tmcintos/MC88110_SmokeTest/README.md

# MC88110_SmokeTest
 MC88110 CPU Test Board
