tmcintos/MC88110_SmokeTest/MC88110_SmokeTest.brd

## EAGLE design MC88110_SmokeTest.brd (2025-04-10)

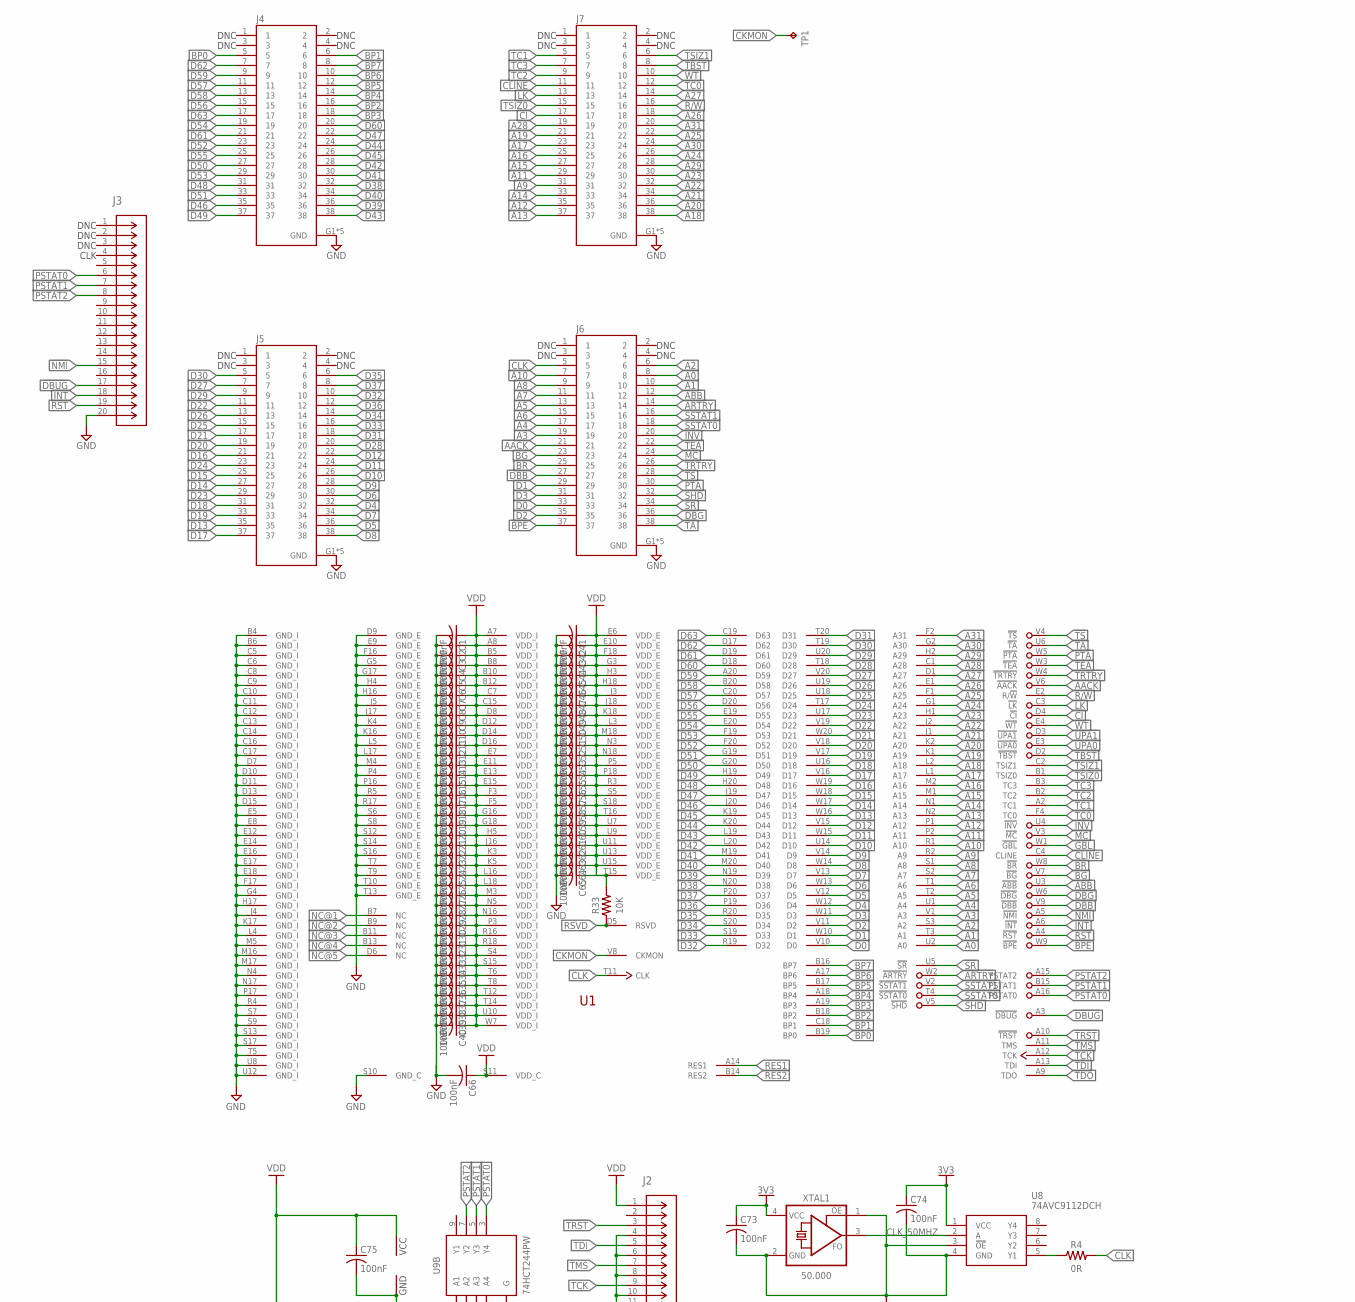
[picture p1: schematic MC88110_SmokeTest.sch, part in row 1, column 1]

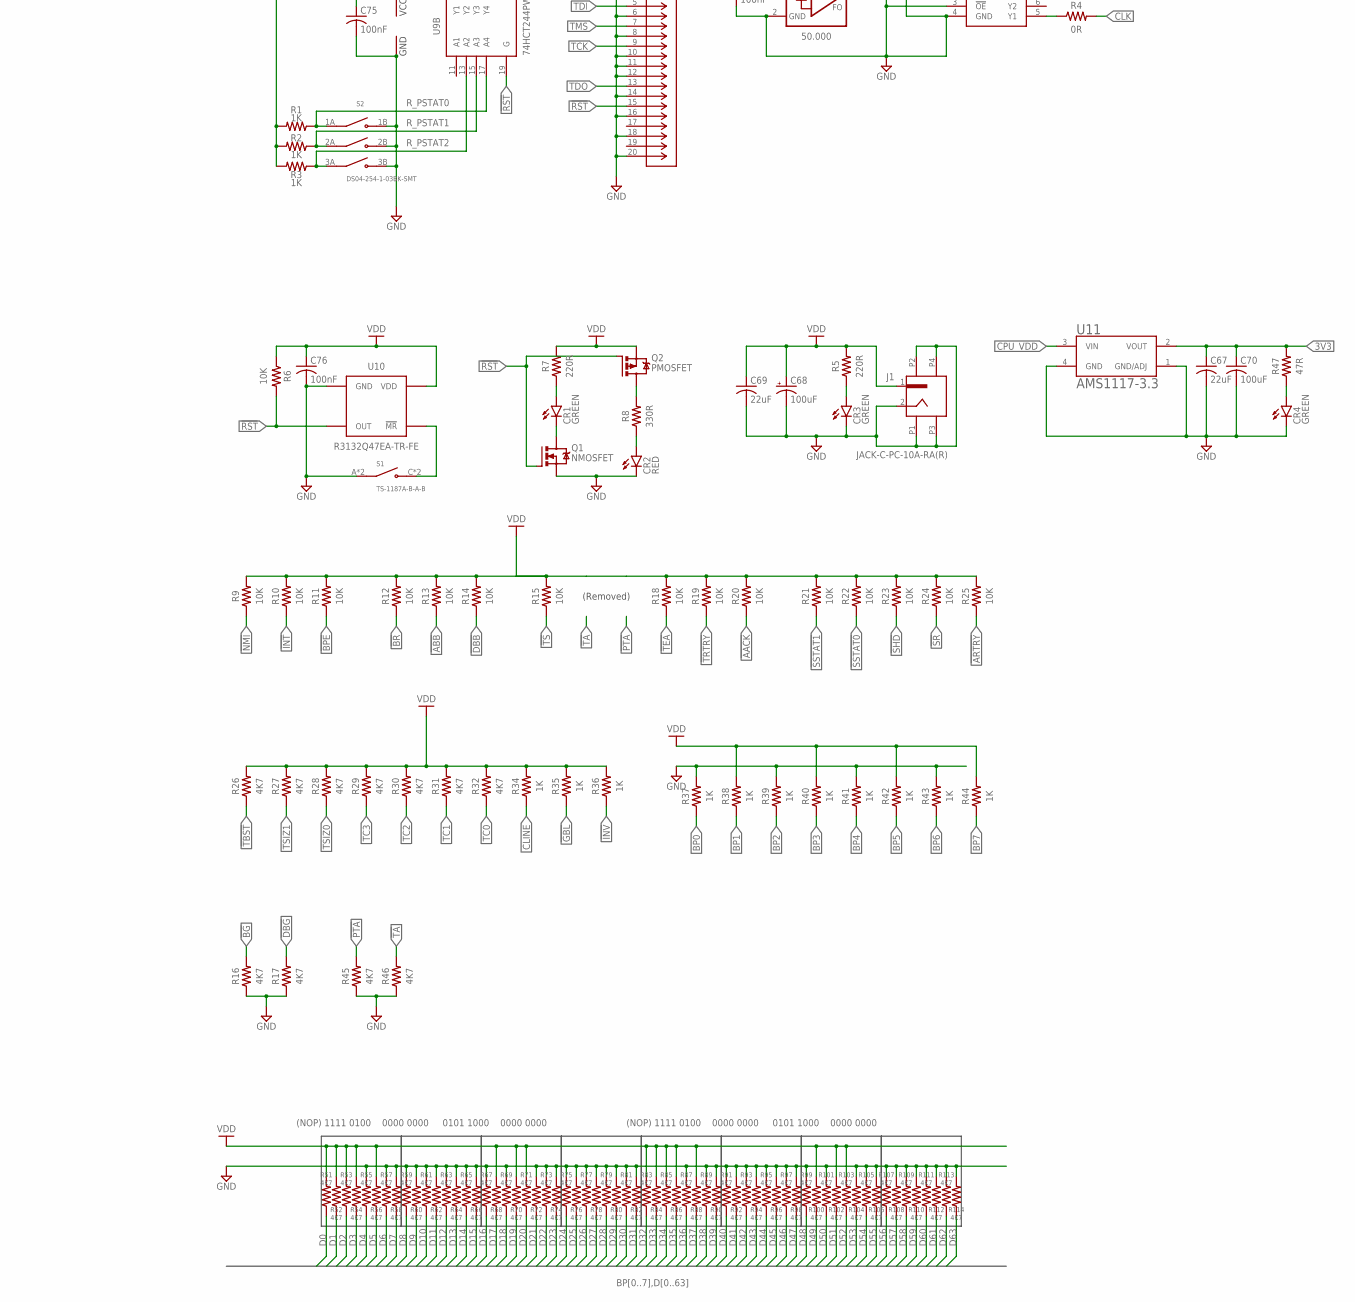
[picture p2: schematic MC88110_SmokeTest.sch, part in row 2, column 1]

Parts:
C1, C2, C3, C4, C5, C6, C7, C8, C9, C10, C11, C12, C13, C14, C15, C16, C17, C18, C19, C20, C21, C22, C23, C24, C25, C26, C27, C28, C29, C30, C31, C32, C33, C34, C35, C36, C37, C38, C39, C40, C41, C42, C43, C44, C45, C46, C47, C48, C49, C50, C51, C52, C53, C54, C55, C56, C57, C58, C59, C60, C61, C62, C63, C64, C65, C66, C73, C74, C75, C76: 100nF; CAPC1608X85; LCSC_PART C14663
C67, C69: 22uF; CAPC1608X85; LCSC_PART C86295
C68: 100uF; CAPMP7343X310N; LCSC_PART C129696
C70: 100uF; CAPC1608X85; LCSC_PART C1955164
CR1, CR3, CR4: GREEN; SML0603; LCSC_PART C12624
CR2: RED; SML0603; LCSC_PART C2286
J1: JACK-C-PC-10A-RA(R); GLOBTECK_JACK-C-PC-10A-RA(R)
J2, J3: 30320-6002HBCONN_30320-6002HB_3MM; CONN_30320-6002HB_3MM; LCSC_PART C5157633
J4, J5, J6, J7: 2-767004-2; TE_2-767004-2; LCSC_PART C2931194
Q1: NMOSFET; SOT23; LCSC_PART C20917
Q2: PMOSFET; SOT23; LCSC_PART C15127
R1, R2, R3, R34, R35, R36, R37, R38, R39, R40, R41, R42, R43, R44: 1K; RESC1608X60; LCSC_PART C21190
R4: 0R; RESC1608X60; LCSC_PART C21189
R5, R7: 220R; RESC1608X60; LCSC_PART C22962
R6, R9, R10, R11, R12, R13, R14, R15, R18, R19, R20, R21, R22, R23, R24, R25, R33: 10K; RESC1608X60; LCSC_PART C25804
R8: 330R; RESC1608X60; LCSC_PART C23138
R16, R17, R26, R27, R28, R29, R30, R31, R32, R45, R46, R51, R52, R53, R54, R55, R56, R57, R58, R59, R60, R61, R62, R63, R64, R65, R66, R67, R68, R69, R70, R71, R72, R73, R74, R75, R76, R77, R78, R79, R80, R81, R82, R83, R84, R85, R86, R87, R88, R89, R90, R91, R92, R93, R94, R95, R96, R97, R98, R99, R100, R101, R102, R103, R104, R105, R106, R107, R108, R109, R110, R111, R112, R113, R114: 4K7; RESC1608X60; LCSC_PART C23162
R47: 47R; RESC1608X60; LCSC_PART C23182
S1: TS-1187A-B-A-B; SW_TS-1187A-B-A-B; LCSC_PART C318884
S2: DS04-254-1-03BK-SMT; SW_DS04-254-1-03BK-SMT; LCSC_PART C129079
TP1: TPTP10R; TP10R
U1: MC88110RC50H; PGA299; LCSC_PART C7187107
U8: 74AVC9112DCH; SOP50P310X100-8N; LCSC_PART C546283
U9: 74HCT244PW; PW20; LCSC_PART C131088
U10: R3132Q47EA-TR-FE; R3132Q; LCSC_PART C2461150
U11: AMS1117-3.3; SOT229P700X180-4N; LCSC_PART C6186
XTAL1: 50.000; OSCCC320X250X90; LCSC_PART C5203552

Connections:
3V3: C67.1, C70.1, C73.1, C74.1, R47.2, U8.1 (VCC), U11.2 (VOUT), XTAL1.4 (VCC)
!AACK: J6.21, R20.1, U1.V6 (!AACK)
!ABB: J6.12, R13.1, U1.U3 (!ABB)
!ARTRY: J6.14, R25.1, U1.W2 (!ARTRY)
!BG: J6.23, R16.2, U1.V7 (!BG)
!BPE: J6.37, R11.1, U1.W9 (!BPE)
!BR: J6.25, R12.1, U1.W8 (!BR)
!CI: J7.17, U1.D4 (!CI)
!DBB: J6.27, R14.1, U1.V9 (!DBB)
!DBG: J6.36, R17.2, U1.W6 (!DBG)
!DBUG: J3.17, U1.A3 (!DBUG)
!GBL: R35.1, U1.W1 (!GBL)
!INT: J3.18, R10.1, U1.A6 (!INT)
!INV: J6.20, R36.1, U1.U4 (!INV)
!LK: J7.13, U1.C3 (!LK)
!MC: J6.24, U1.V3 (!MC)
!MR: S1.C (NO), S1.D (NO), U10.P$3 (!MR)
!NMI: J3.15, R9.1, U1.A5 (!NMI)
!PTA: J6.30, R45.2, U1.W5 (!PTA)
!RST: J2.15, J3.19, Q1.1 (G), Q2.1 (G), R6.2, U1.A4 (!RST), U9.19 (G), U10.P$2 (OUT)
!SHD: J6.32, R23.1, U1.V5 (!SHD)
!SR: J6.34, R24.1, U1.U5 (!SR)
!SSTAT0: J6.18, R22.1, U1.T4 (!SSTAT0)
!SSTAT1: J6.16, R21.1, U1.V2 (!SSTAT1)
!TA: J6.38, R46.2, U1.U6 (!TA)
!TBST: J7.8, R26.1, U1.D2 (!TBST)
!TEA: J6.22, R18.1, U1.W3 (!TEA)
!TRST: J2.3, U1.A10 (!TRST)
!TRTRY: J6.26, R19.1, U1.W4 (!TRTRY)
!TS: J6.28, R15.1, U1.V4 (!TS)
!UPA0: U1.E3 (!UPA0)
!UPA1: U1.D3 (!UPA1)
!WT: J7.10, U1.E4 (!WT)
A0: J6.8, U1.U2 (A0)
A1: J6.10, U1.T3 (A1)
A2: J6.6, U1.S3 (A2)
A3: J6.19, U1.V1 (A3)
A4: J6.17, U1.U1 (A4)
A5: J6.13, U1.T2 (A5)
A6: J6.15, U1.T1 (A6)
A7: J6.11, U1.S2 (A7)
A8: J6.9, U1.S1 (A8)
A9: J7.31, U1.R2 (A9)
A10: J6.7, U1.R1 (A10)
A11: J7.29, U1.P2 (A11)
A12: J7.35, U1.P1 (A12)
A13: J7.37, U1.N2 (A13)
A14: J7.33, U1.N1 (A14)
A15: J7.27, U1.M1 (A15)
A16: J7.25, U1.M2 (A16)
A17: J7.23, U1.L1 (A17)
A18: J7.38, U1.L2 (A18)
A19: J7.21, U1.K1 (A19)
A20: J7.36, U1.K2 (A20)
A21: J7.34, U1.J1 (A21)
A22: J7.32, U1.J2 (A22)
A23: J7.30, U1.H1 (A23)
A24: J7.26, U1.G1 (A24)
A25: J7.22, U1.F1 (A25)
A26: J7.18, U1.E1 (A26)
A27: J7.14, U1.D1 (A27)
A28: J7.19, U1.C1 (A28)
A29: J7.28, U1.H2 (A29)
A30: J7.24, U1.G2 (A30)
A31: J7.20, U1.F2 (A31)
BP0: J4.5, R37.1, U1.B19 (BP0)
BP1: J4.6, R38.1, U1.C18 (BP1)
BP2: J4.16, R39.1, U1.B18 (BP2)
BP3: J4.18, R40.1, U1.A19 (BP3)
BP4: J4.14, R41.1, U1.A18 (BP4)
BP5: J4.12, R42.1, U1.B17 (BP5)
BP6: J4.10, R43.1, U1.A17 (BP6)
BP7: J4.8, R44.1, U1.B16 (BP7)
CKMON: TP1.TP, U1.V8 (CKMON)
CLINE: J7.11, R34.1, U1.C4 (CLINE)
CLK: J6.5, R4.2, U1.T11 (CLK)
CLK_50MHZ: U8.2 (A), XTAL1.3 (FO)
CPU_VDD: C1.1, C2.1, C3.1, C4.1, C5.1, C6.1, C7.1, C8.1, C9.1, C10.1, C11.1, C12.1, C13.1, C14.1, C15.1, C16.1, C17.1, C18.1, C19.1, C20.1, C21.1, C22.1, C23.1, C24.1, C25.1, C26.1, C27.1, C28.1, C29.1, C30.1, C31.1, C32.1, C33.1, C34.1, C35.1, C36.1, C37.1, C38.1, C39.1, C40.1, C41.1, C42.1, C43.1, C44.1, C45.1, C46.1, C47.1, C48.1, C49.1, C50.1, C51.1, C52.1, C53.1, C54.1, C55.1, C56.1, C57.1, C58.1, C59.1, C60.1, C61.1, C62.1, C63.1, C64.1, C65.1, C66.1, C68.1 (+), C69.1, C75.1, C76.1, J1.1, J2.1, Q2.2 (S), R1.2, R2.2, R3.2, R5.2, R6.1, R7.2, R9.2, R10.2, R11.2, R12.2, R13.2, R14.2, R15.2, R18.2, R19.2, R20.2, R21.2, R22.2, R23.2, R24.2, R25.2, R26.2, R27.2, R28.2, R29.2, R30.2, R31.2, R32.2, R33.2, R34.2, R35.2, R36.2, R38.2, R40.2, R42.2, R44.2, R51.2, R52.2, R53.2, R54.2, R56.2, R68.2, R70.2, R71.2, R83.2, R84.2, R85.2, R86.2, R88.2, R100.2, R102.2, R103.2, U1.A7 (VDD_I), U1.A8 (VDD_I), U1.B5 (VDD_I), U1.B8 (VDD_I), U1.B10 (VDD_I), U1.B12 (VDD_I), U1.C7 (VDD_I), U1.C15 (VDD_I), U1.D8 (VDD_I), U1.D12 (VDD_I), U1.D14 (VDD_I), U1.D16 (VDD_I), U1.E6 (VDD_E), U1.E7 (VDD_I), U1.E10 (VDD_E), U1.E11 (VDD_I), U1.E13 (VDD_I), U1.E15 (VDD_I), U1.F3 (VDD_I), U1.F5 (VDD_I), U1.F18 (VDD_E), U1.G3 (VDD_E), U1.G16 (VDD_I), U1.G18 (VDD_I), U1.H3 (VDD_E), U1.H5 (VDD_I), U1.H18 (VDD_E), U1.J3 (VDD_E), U1.J16 (VDD_I), U1.J18 (VDD_E), U1.K3 (VDD_I), U1.K5 (VDD_I), U1.K18 (VDD_E), U1.L3 (VDD_E), U1.L16 (VDD_I), U1.L18 (VDD_I), U1.M3 (VDD_I), U1.M18 (VDD_E), U1.N3 (VDD_E), U1.N5 (VDD_I), U1.N16 (VDD_I), U1.N18 (VDD_E), U1.P3 (VDD_I), U1.P5 (VDD_E), U1.P18 (VDD_E), U1.R3 (VDD_E), U1.R16 (VDD_I), U1.R18 (VDD_I), U1.S4 (VDD_I), U1.S5 (VDD_E), U1.S11 (VDD_C), U1.S15 (VDD_I), U1.S18 (VDD_E), U1.T6 (VDD_I), U1.T8 (VDD_I), U1.T12 (VDD_I), U1.T14 (VDD_I), U1.T15 (VDD_E), U1.T16 (VDD_E), U1.U7 (VDD_E), U1.U9 (VDD_E), U1.U10 (VDD_I), U1.U11 (VDD_E), U1.U13 (VDD_E), U1.U15 (VDD_E), U1.W7 (VDD_I), U9.20 (VCC), U10.P$4 (VDD), U11.3 (VIN)
D0: J6.33, R51.1, U1.V10 (D0)
D1: J6.29, R52.1, U1.W10 (D1)
D2: J6.35, R53.1, U1.V11 (D2)
D3: J6.31, R54.1, U1.W11 (D3)
D4: J5.32, R55.1, U1.W12 (D4)
D5: J5.36, R56.1, U1.V12 (D5)
D6: J5.30, R57.1, U1.W13 (D6)
D7: J5.34, R58.1, U1.V13 (D7)
D8: J5.38, R59.1, U1.W14 (D8)
D9: J5.28, R60.1, U1.V14 (D9)
D10: J5.26, R61.1, U1.U14 (D10)
D11: J5.24, R62.1, U1.W15 (D11)
D12: J5.22, R63.1, U1.V15 (D12)
D13: J5.35, R64.1, U1.W16 (D13)
D14: J5.27, R65.1, U1.W17 (D14)
D15: J5.25, R66.1, U1.W18 (D15)
D16: J5.21, R67.1, U1.W19 (D16)
D17: J5.37, R68.1, U1.V16 (D17)
D18: J5.31, R69.1, U1.U16 (D18)
D19: J5.33, R70.1, U1.V17 (D19)
D20: J5.19, R71.1, U1.V18 (D20)
D21: J5.17, R72.1, U1.W20 (D21)
D22: J5.11, R73.1, U1.V19 (D22)
D23: J5.29, R74.1, U1.U17 (D23)
D24: J5.23, R75.1, U1.T17 (D24)
D25: J5.15, R76.1, U1.U18 (D25)
D26: J5.13, R77.1, U1.U19 (D26)
D27: J5.7, R78.1, U1.V20 (D27)
D28: J5.20, R79.1, U1.T18 (D28)
D29: J5.9, R80.1, U1.U20 (D29)
D30: J5.5, R81.1, U1.T19 (D30)
D31: J5.18, R82.1, U1.T20 (D31)
D32: J5.10, R83.1, U1.R19 (D32)
D33: J5.16, R84.1, U1.S19 (D33)
D34: J5.14, R85.1, U1.S20 (D34)
D35: J5.6, R86.1, U1.R20 (D35)
D36: J5.12, R87.1, U1.P19 (D36)
D37: J5.8, R88.1, U1.P20 (D37)
D38: J4.32, R89.1, U1.N20 (D38)
D39: J4.36, R90.1, U1.N19 (D39)
D40: J4.34, R91.1, U1.M20 (D40)
D41: J4.30, R92.1, U1.M19 (D41)
D42: J4.28, R93.1, U1.L20 (D42)
D43: J4.38, R94.1, U1.L19 (D43)
D44: J4.24, R95.1, U1.K20 (D44)
D45: J4.26, R96.1, U1.K19 (D45)
D46: J4.35, R97.1, U1.J20 (D46)
D47: J4.22, R98.1, U1.J19 (D47)
D48: J4.31, R99.1, U1.H20 (D48)
D49: J4.37, R100.1, U1.H19 (D49)
D50: J4.27, R101.1, U1.G20 (D50)
D51: J4.33, R102.1, U1.G19 (D51)
D52: J4.23, R103.1, U1.F20 (D52)
D53: J4.29, R104.1, U1.F19 (D53)
D54: J4.19, R105.1, U1.E20 (D54)
D55: J4.25, R106.1, U1.E19 (D55)
D56: J4.15, R107.1, U1.D20 (D56)
D57: J4.11, R108.1, U1.C20 (D57)
D58: J4.13, R109.1, U1.B20 (D58)
D59: J4.9, R110.1, U1.A20 (D59)
D60: J4.20, R111.1, U1.D18 (D60)
D61: J4.21, R112.1, U1.D19 (D61)
D62: J4.7, R113.1, U1.D17 (D62)
D63: J4.17, R114.1, U1.C19 (D63)
GND: C1.2, C2.2, C3.2, C4.2, C5.2, C6.2, C7.2, C8.2, C9.2, C10.2, C11.2, C12.2, C13.2, C14.2, C15.2, C16.2, C17.2, C18.2, C19.2, C20.2, C21.2, C22.2, C23.2, C24.2, C25.2, C26.2, C27.2, C28.2, C29.2, C30.2, C31.2, C32.2, C33.2, C34.2, C35.2, C36.2, C37.2, C38.2, C39.2, C40.2, C41.2, C42.2, C43.2, C44.2, C45.2, C46.2, C47.2, C48.2, C49.2, C50.2, C51.2, C52.2, C53.2, C54.2, C55.2, C56.2, C57.2, C58.2, C59.2, C60.2, C61.2, C62.2, C63.2, C64.2, C65.2, C66.2, C67.2, C68.2 (-), C69.2, C70.2, C73.2, C74.2, C75.2, C76.2, CR2.C, CR3.C, CR4.C, J1.2, J1.P1, J1.P2, J1.P3, J1.P4, J2.4, J2.6, J2.8, J2.10, J2.11, J2.12, J2.14, J2.16, J2.18, J2.20, J3.20, J4.G1 (GND), J4.G2 (GND), J4.G3 (GND), J4.G4 (GND), J4.G5 (GND), J5.G1 (GND), J5.G2 (GND), J5.G3 (GND), J5.G4 (GND), J5.G5 (GND), J6.G1 (GND), J6.G2 (GND), J6.G3 (GND), J6.G4 (GND), J6.G5 (GND), J7.G1 (GND), J7.G2 (GND), J7.G3 (GND), J7.G4 (GND), J7.G5 (GND), Q1.2 (S), R16.1, R17.1, R37.2, R39.2, R41.2, R43.2, R45.1, R46.1, R55.2, R57.2, R58.2, R59.2, R60.2, R61.2, R62.2, R63.2, R64.2, R65.2, R66.2, R67.2, R69.2, R72.2, R73.2, R74.2, R75.2, R76.2, R77.2, R78.2, R79.2, R80.2, R81.2, R82.2, R87.2, R89.2, R90.2, R91.2, R92.2, R93.2, R94.2, R95.2, R96.2, R97.2, R98.2, R99.2, R101.2, R104.2, R105.2, R106.2, R107.2, R108.2, R109.2, R110.2, R111.2, R112.2, R113.2, R114.2, S1.A (COM), S1.B (COM), S2.1B (NO1), S2.2B (NO2), S2.3B (NO3), U1.B4 (GND_I), U1.B6 (GND_I), U1.C5 (GND_I), U1.C6 (GND_I), U1.C8 (GND_I), U1.C9 (GND_I), U1.C10 (GND_I), U1.C11 (GND_I), U1.C12 (GND_I), U1.C13 (GND_I), U1.C14 (GND_I), U1.C16 (GND_I), U1.C17 (GND_I), U1.D7 (GND_I), U1.D9 (GND_E), U1.D10 (GND_I), U1.D11 (GND_I), U1.D13 (GND_I), U1.D15 (GND_I), U1.E5 (GND_I), U1.E8 (GND_I), U1.E9 (GND_E), U1.E12 (GND_I), U1.E14 (GND_I), U1.E16 (GND_I), U1.E17 (GND_I), U1.E18 (GND_I), U1.F16 (GND_E), U1.F17 (GND_I), U1.G4 (GND_I), U1.G5 (GND_E), U1.G17 (GND_E), U1.H4 (GND_E), U1.H16 (GND_E), U1.H17 (GND_I), U1.J4 (GND_I), U1.J5 (GND_E), U1.J17 (GND_E), U1.K4 (GND_E), U1.K16 (GND_E), U1.K17 (GND_I), U1.L4 (GND_I), U1.L5 (GND_E), U1.L17 (GND_E), U1.M4 (GND_E), U1.M5 (GND_I), U1.M16 (GND_I), U1.M17 (GND_I), U1.N4 (GND_I), U1.N17 (GND_I), U1.P4 (GND_E), U1.P16 (GND_E), U1.P17 (GND_I), U1.R4 (GND_I), U1.R5 (GND_E), U1.R17 (GND_E), U1.S6 (GND_E), U1.S7 (GND_I), U1.S8 (GND_E), U1.S9 (GND_I), U1.S10 (GND_C), U1.S12 (GND_E), U1.S13 (GND_I), U1.S14 (GND_E), U1.S16 (GND_E), U1.S17 (GND_I), U1.T5 (GND_I), U1.T7 (GND_E), U1.T9 (GND_E), U1.T10 (GND_E), U1.T13 (GND_E), U1.U8 (GND_I), U1.U12 (GND_I), U8.3 (!OE), U8.4 (GND), U9.10 (GND), U10.P$1 (GND), U11.1 (GND/ADJ), U11.4 (GND), XTAL1.1 (OE), XTAL1.2 (GND)
LED1+: CR1.A, R7.1
LED1+1: CR3.A, R5.1
LED1+2: CR4.A, R47.1
LED1-: CR1.C, Q1.3 (D)
LED2+: CR2.A, R8.1
LV_CLK_CPU_R: R4.1, U8.5 (Y1)
NC@1: U1.B7 (NC)
NC@2: U1.B9 (NC)
NC@3: U1.B11 (NC)
NC@4: U1.B13 (NC)
NC@5: U1.D6 (NC)
PSTAT0: J3.6, U1.A16 (PSTAT0), U9.3 (Y4)
PSTAT1: J3.7, U1.B15 (PSTAT1), U9.5 (Y3)
PSTAT2: J3.8, U1.A15 (PSTAT2), U9.7 (Y2)
R11+: Q2.3 (D), R8.2
R/!W: J7.16, U1.E2 (R/!W)
RES1: U1.A14 (RES1)
RES2: U1.B14 (RES2)
RSVD: R33.1, U1.D5 (RSVD)
R_PSTAT0: R1.1, S2.1A (COM1), U9.17 (A4)
R_PSTAT1: R2.1, S2.2A (COM2), U9.15 (A3)
R_PSTAT2: R3.1, S2.3A (COM3), U9.13 (A2)
TC0: J7.12, R32.1, U1.F4 (TC0)
TC1: J7.5, R31.1, U1.A2 (TC1)
TC2: J7.9, R30.1, U1.B2 (TC2)
TC3: J7.7, R29.1, U1.B3 (TC3)
TCK: J2.9, U1.A12 (TCK)
TDI: J2.5, U1.A13 (TDI)
TDO: J2.13, U1.A9 (TDO)
TMS: J2.7, U1.A11 (TMS)
TSIZ0: J7.15, R28.1, U1.B1 (TSIZ0)
TSIZ1: J7.6, R27.1, U1.C2 (TSIZ1)

Notes on the sheet:
DNC
CLK
(Removed)
(NOP) 1111 0100 0000 0000 0101 1000 0000 0000

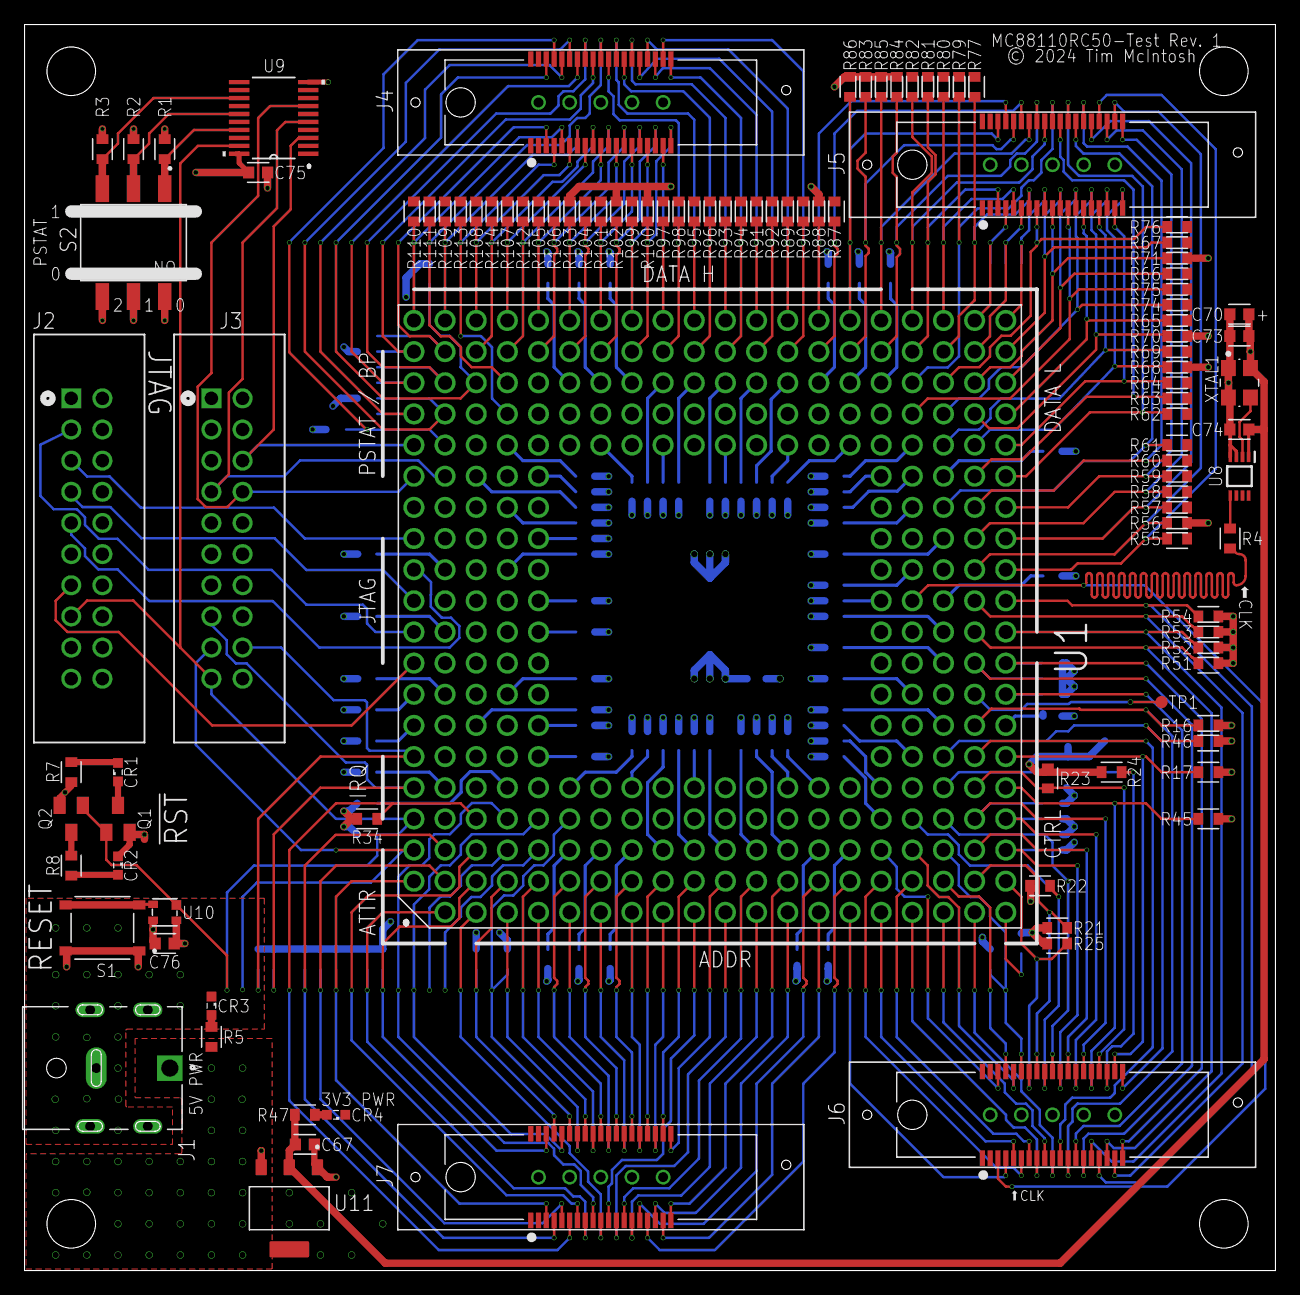
[picture p3: board MC88110_SmokeTest.brd from above]

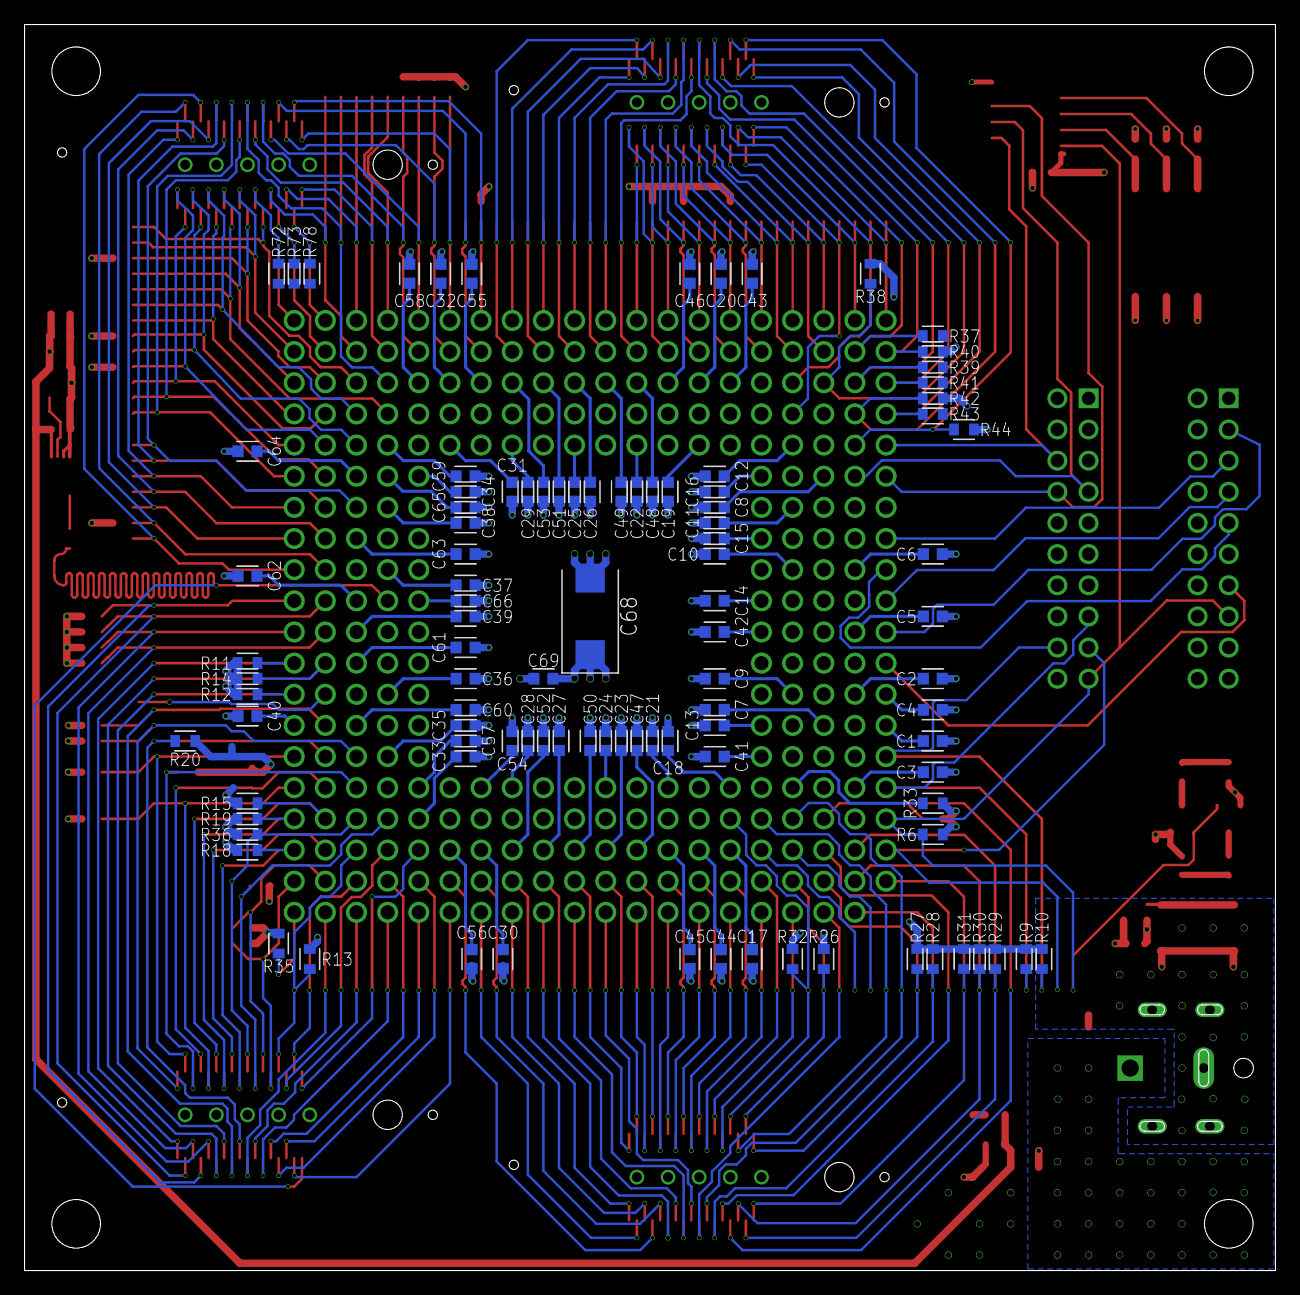
[picture p4: board MC88110_SmokeTest.brd from below]

Board: 4 copper layers, 102.0 x 101.6 mm, 207 parts (100 on the bottom side), 166 nets.
