tmcintos/MC88110_SmokeTest/(commit log)

2025-04-10 v91 EAGLE9.X export
    [MC88110_SmokeTest.brd, MC88110_SmokeTest.sch]
2025-04-10 Create Rework_Errata.pdf
    Add rework/errata document for the version that I had manufactured by JLCPCB last year (v81), which had a few issues.
    I don’t think I corrected all of the issues in the schematic/PCB before pausing work last year. From the Fusion history, it appears that I may only have corrected the problem with CR- described in step #5 (in v85).
