tmcintos/MC88110_SmokeTest/(notices)

Notices in the files:
MC88110_SmokeTest.brd:
© 2024 Tim McIntosh
parts and their libraries:
30320-6002: COPYRIGHT: Copyright (C) 2024 Ultra Librarian. All rights reserved.
